emisilve86/Lighting-LEDs-ATmega328P/images/Programming.jpg

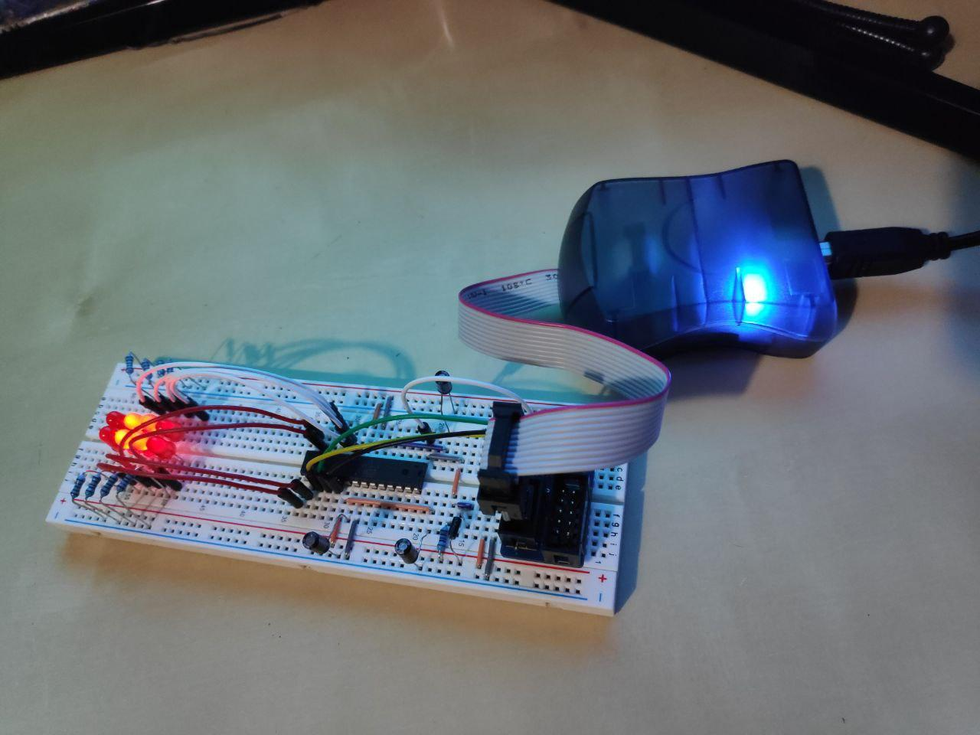
images/Programming.jpg
